Xenosb/thesis-atmel/README.md

# thesis-atmel

## Libraries
Some of the symbols and footprints are from KiCad Library
```https://github.com/KiCad/kicad-library```
