Xenosb/thesis-atmel/pcb/smartbed.kicad_pcb

## KiCad design pcb/smartbed.kicad_pcb (2017-06-22)

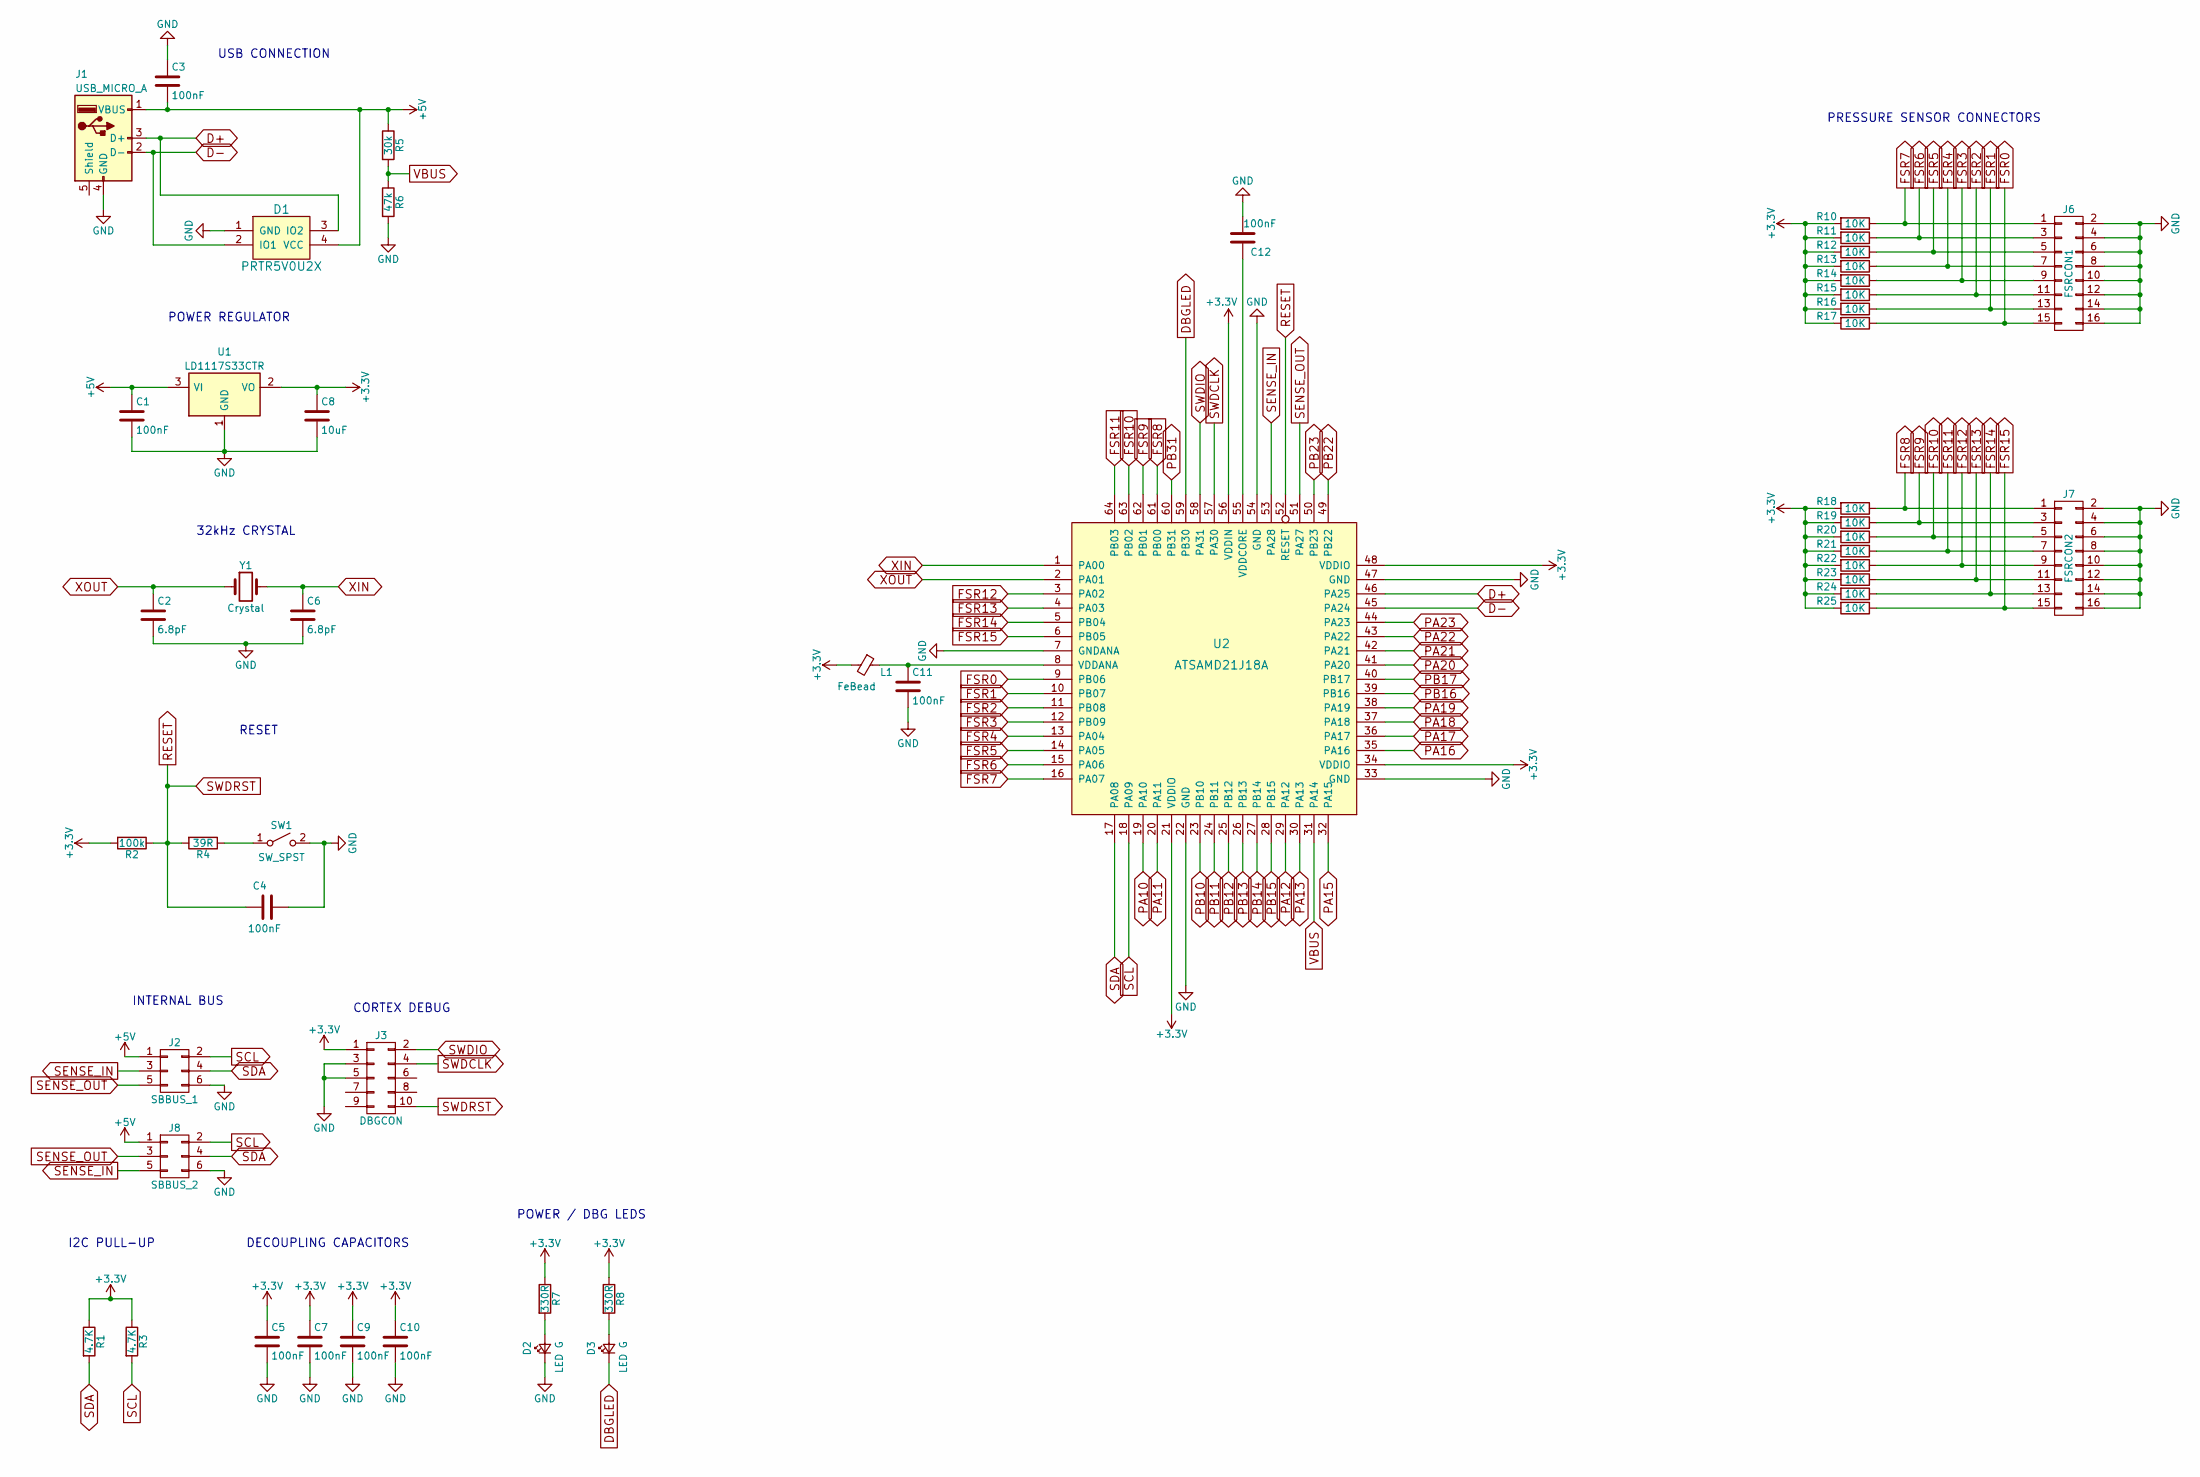
[picture p3: schematic smartbed.sch, Smartbed sense node]

Parts:
C1, C3, C4, C5, C7, C9, C10, C11, C12: 100nF; C_0603_HandSoldering
C2, C6: 6.8pF; C_0603_HandSoldering
C8: 10uF; C_0603_HandSoldering
D1: PRTR5V0U2X; SOT-143_Handsoldering
D2, D3: LED G; LED_0805
J1: USB_MICRO_A; USB_Micro-B
J2: SBBUS_1; IDC_Header_Straight_6pins
J3: DBGCON; IDC_Header_Straight_10pins
J6: FSRCON1; Pin_Header_Angled_2x08_Pitch2.54mm
J7: FSRCON2; Pin_Header_Angled_2x08_Pitch2.54mm
J8: SBBUS_2; IDC_Header_Straight_6pins
L1: FeBead; L_0603_HandSoldering
R1, R3: 4.7K; R_0805_HandSoldering
R2: 100k; R_0805_HandSoldering
R4: 39R; R_0805_HandSoldering
R5: 30k; R_0805_HandSoldering
R6: 47k; R_0805_HandSoldering
R7, R8: 330R; R_0805_HandSoldering
R10, R11, R12, R13, R14, R15, R16, R17, R18, R19, R20, R21, R22, R23, R24, R25: 10K; R_0805_HandSoldering
SW1: SW_SPST; SW_SPST_B3SL-1002P
U1: LD1117S33CTR; SOT-223
U2: ATSAMD21J18A; TQFP-64_10x10mm_Pitch0.5mm
Y1: Crystal; Crystal_Round_d3.0mm_Vertical

Connections:
+3V3: C5.1, C7.1, C8.1, C9.1, C10.1, J3.1, L1.2, R1.1, R2.2, R3.1, R7.1, R8.1, R10.2, R11.2, R12.2, R13.2, R14.2, R15.2, R16.2, R17.2, R18.2, R19.2, R20.2, R21.2, R22.2, R23.2, R24.2, R25.2, U1.2 (VO), U2.21 (VDDIO), U2.34 (VDDIO), U2.48 (VDDIO), U2.56 (VDDIN)
+5V: C1.1, C3.2, D1.4 (VCC), J1.1 (VBUS), J2.1, J8.1, R5.1, U1.3 (VI)
D+: D1.3 (IO2), J1.3 (D+), U2.46 (PA25)
D-: D1.2 (IO1), J1.2 (D-), U2.45 (PA24)
DBGLED: D3.1 (K), U2.59 (PB30)
FSR0: J6.15, R17.1, U2.9 (PB06)
FSR1: J6.13, R16.1, U2.10 (PB07)
FSR2: J6.11, R15.1, U2.11 (PB08)
FSR3: J6.9, R14.1, U2.12 (PB09)
FSR4: J6.7, R13.1, U2.13 (PA04)
FSR5: J6.5, R12.1, U2.14 (PA05)
FSR6: J6.3, R11.1, U2.15 (PA06)
FSR7: J6.1, R10.1, U2.16 (PA07)
FSR8: J7.1, R18.1, U2.61 (PB00)
FSR9: J7.3, R19.1, U2.62 (PB01)
FSR10: J7.5, R20.1, U2.63 (PB02)
FSR11: J7.7, R21.1, U2.64 (PB03)
FSR12: J7.9, R22.1, U2.3 (PA02)
FSR13: J7.11, R23.1, U2.4 (PA03)
FSR14: J7.13, R24.1, U2.5 (PB04)
FSR15: J7.15, R25.1, U2.6 (PB05)
GND: C1.2, C2.2, C3.1, C4.2, C5.2, C6.2, C7.2, C8.2, C9.2, C10.2, C11.2, C12.1, D1.1 (GND), D2.1 (K), J1.4 (GND), J2.6, J3.3, J3.5, J6.2, J6.4, J6.6, J6.8, J6.10, J6.12, J6.14, J6.16, J7.2, J7.4, J7.6, J7.8, J7.10, J7.12, J7.14, J7.16, J8.6, R6.2, SW1.2 (B), U1.1 (GND), U2.7 (GNDANA), U2.22 (GND), U2.33 (GND), U2.47 (GND), U2.54 (GND)
unnamed: C11.1, L1.1, U2.8 (VDDANA)
unnamed: C12.2, U2.55 (VDDCORE)
unnamed: D2.2 (A), R7.2
unnamed: D3.2 (A), R8.2
unnamed: R4.1, SW1.1 (A)
PA10: U2.19 (PA10)
PA11: U2.20 (PA11)
PA12: U2.29 (PA12)
PA13: U2.30 (PA13)
PA15: U2.32 (PA15)
PA16: U2.35 (PA16)
PA17: U2.36 (PA17)
PA18: U2.37 (PA18)
PA19: U2.38 (PA19)
PA20: U2.41 (PA20)
PA21: U2.42 (PA21)
PA22: U2.43 (PA22)
PA23: U2.44 (PA23)
PB10: U2.23 (PB10)
PB11: U2.24 (PB11)
PB12: U2.25 (PB12)
PB13: U2.26 (PB13)
PB14: U2.27 (PB14)
PB15: U2.28 (PB15)
PB16: U2.39 (PB16)
PB17: U2.40 (PB17)
PB22: U2.49 (PB22)
PB23: U2.50 (PB23)
PB31: U2.60 (PB31)
RESET: C4.1, J3.10, R2.1, R4.2, U2.52 (RESET)
SCL: J2.2, J8.2, R3.2, U2.18 (PA09)
SDA: J2.4, J8.4, R1.2, U2.17 (PA08)
SENSE_IN: J2.3, J8.5, U2.53 (PA28)
SENSE_OUT: J2.5, J8.3, U2.51 (PA27)
SWDCLK: J3.4, U2.57 (PA30)
SWDIO: J3.2, U2.58 (PA31)
VBUS: R5.2, R6.1, U2.31 (PA14)
XIN: C6.1, U2.1 (PA00), Y1.2
XOUT: C2.1, U2.2 (PA01), Y1.1

Notes on the sheet:
USB CONNECTION
INTERNAL BUS
POWER REGULATOR
32kHz CRYSTAL
RESET
I2C PULL-UP
CORTEX DEBUG
DECOUPLING CAPACITORS
POWER / DBG LEDS
PRESSURE SENSOR CONNECTORS

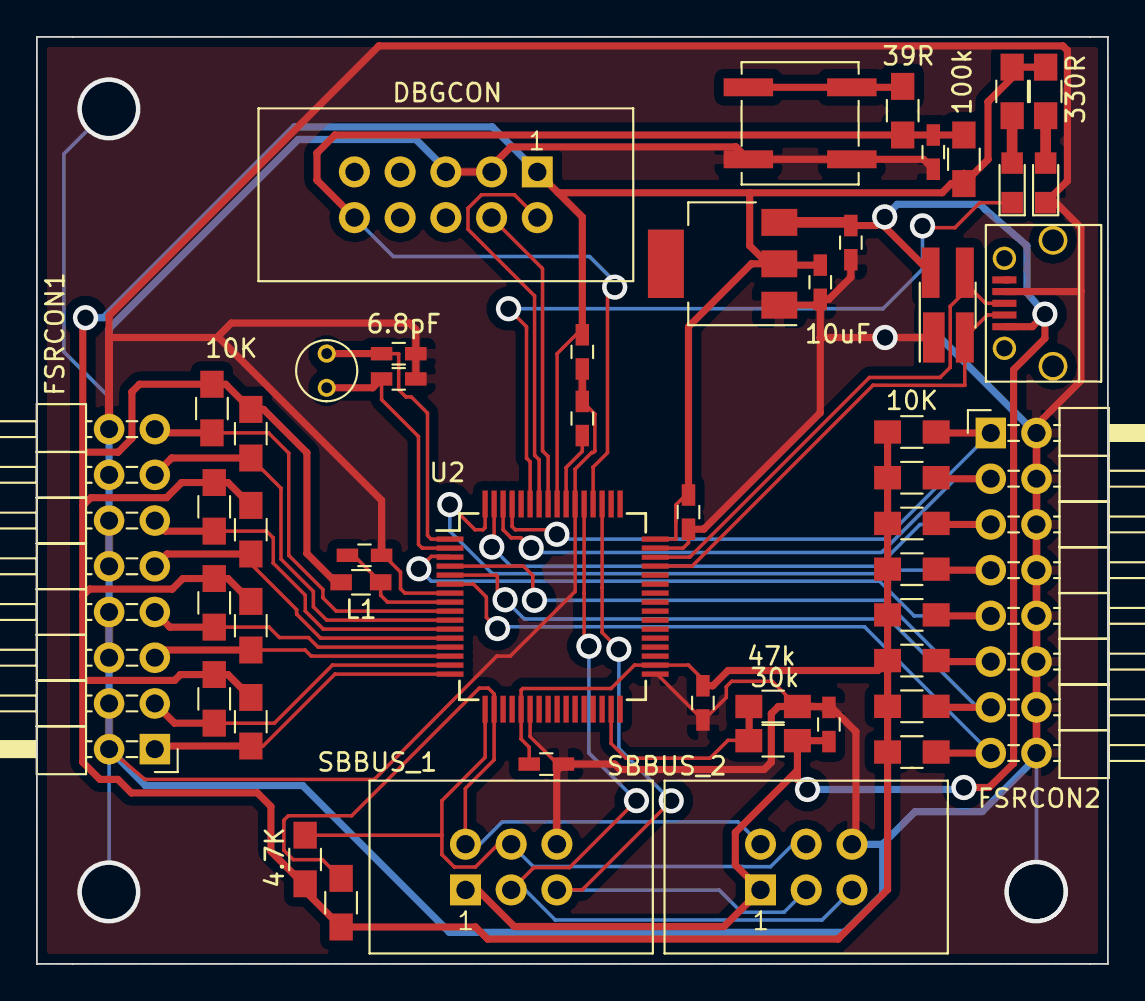
[picture p4: board smartbed.kicad_pcb from above]

Board: 2 copper layers, 59.5 x 51.5 mm, 50 parts (0 on the bottom side), 37 nets.
