Xenosb/thesis-atmel/firmware/src/main.cpp

#include "main.hpp"

I2CSlave slave(I2C_SDA_PIN, I2C_SCL_PIN);
DigitalOut led(LED_PIN);
DigitalIn sense_in(SENSE_IN_PIN);
DigitalOut sense_out(SENSE_OUT_PIN);
Smartbed smartbed(NODE_ADR, SENSOR_NUMBER);
Sensors sensors;
Ticker sensor_updater;

/**
==================
Main loop function
==================
*/
int main()
{

  led = 1;
  sense_out = 0;
  sense_in.mode(PullDown);

  slave.frequency(I2C_FREQ);
  slave.address(NODE_ADR);

  I2C_RESULT i2c_data;

  sensor_updater.attach(&update_all_sensors, 0.1);

  while (1)
  {
    i2c_data = i2c_slave_worker(slave);
    process_i2c_call(i2c_data);
  }
}

void update_all_sensors()
{
  sensors.update_all_sensors();
}

/**
====================
I2C process function
====================
*/
void process_i2c_call(I2C_RESULT i2c_data)
{
  switch (i2c_data.type)
  {
  case I2C_RESULT::None:
    return;
  case I2C_RESULT::WriteAddressed:
    process_write(i2c_data);
    break;
  case I2C_RESULT::ReadAddressed:
    // led = !led;
    process_read(i2c_data);
    break;
  case I2C_RESULT::WriteBroadcasted:
    process_broadcast(i2c_data);
    break;
  }
}

/**
===============================
Process write actions to node

registers
0xfa          - set i2c address
0xf0          - set sense_out
===============================
**/
void process_write(I2C_RESULT i2c_data)
{
  switch (i2c_data.reg)
  {
  case 0xfa:
    if (sense_in) {
      smartbed.set_address(i2c_data.reg_value);
      slave.address(i2c_data.reg_value);
    }
    break;
  case 0xf0:
    sense_out.write(i2c_data.reg_value);
    break;
  default:
    return;
  }
  slave.stop();
}

/**
========================================
Process read actions to node

registers
0x00 ... 0x0f - sensors individually (2B)
0xa0          - all sensors (sensor_n*2B)
0xfa          - i2c address (1B)
0xfb          - number of active sensors (1B)
0xfc          - board revision (1B)
0xfd          - firmware version (1B)
default       - echo 0xab == 17 (1B)
========================================
**/
void process_read(I2C_RESULT i2c_data)
{
  int i;
  uint16_t sensor_value;
  char sensor_vals[2];

  switch (i2c_data.reg)
  {
  case 0 ... 15:
    sensor_value = sensors.get_sensor(i2c_data.reg);
    sensor_vals[0] = char(sensor_value & 0x00ff);
    sensor_vals[1] = char(sensor_value >> 8);
    slave.write(sensor_vals, 2);
    break;
  case 0xa0:
    for (i=0; i<SENSOR_NUMBER; i++)
    {
      sensor_value = sensors.get_sensor(i);
      sensor_vals[0] = char(sensor_value & 0x00ff);
      sensor_vals[1] = char(sensor_value >> 8);
      slave.write(sensor_vals, 2);
    }
    break;
  case 0xfa:
    led != led;
    slave.write(smartbed.get_address());
    if (smartbed.get_address() == NODE_ADR)
      led = !led;
    break;
  case 0xfb:
    slave.write(smartbed.get_sensor_number());
    break;
  case 0xfc:
    slave.write(HW_VER);
    break;
  case 0xfd:
    slave.write(SW_VER);
    break;
  default:
    slave.write(0xab);
    return;
  }
  slave.stop();
}

/**
===========================================================
Process broadcast actions to node

accepted messages
[0xfa, 0x??]    - sets the node address if sense_in active
===========================================================
**/
void process_broadcast(I2C_RESULT i2c_data)
{
  if (i2c_data.data_length == 2 && i2c_data.long_data[0] == 0xfa && sense_in )
  {
    smartbed.set_address(i2c_data.long_data[1]);
  }
}

/**
==========================
I2C slave worker procedure
==========================
**/
I2C_RESULT i2c_slave_worker(I2CSlave slave)
{

  I2C_BYTE node_address = I2C_BYTE(slave.read());

  /* This slave was not addressed */
  if (node_address.data == -1)
  {
    return I2C_RESULT();
  }

  /* This slave was addressed with write */
  if (node_address.addr == smartbed.get_address() && !node_address.n_write)
  {

    int node_register = slave.read();
    I2C_BYTE read_write = I2C_BYTE(slave.read());

    if (read_write.n_write && read_write.addr == smartbed.get_address())
    {
      /* Master requests read from registry */
      return I2C_RESULT(node_register);
    }
    else
    {
      /* Master wrote to slave registry */
      return I2C_RESULT(node_register, read_write.data);
    }
  }

  if (node_address.addr == 0x00)
  {
    /* Broadcast to all slaves */
    int data[MAX_I2C_DATA_SIZE];
    int length = 0;

    while (true)
    {
      int r_byte = slave.read();
      if (r_byte == -1)
        break;
      data[length] = r_byte;
      length++;
    }

    return I2C_RESULT(length, data);
  }

  return I2C_RESULT();
}
