Xenosb/thesis-atmel/(commit log)

2017-06-08 Added SAMD21 to library
    [smartbed.kicad_pcb, smartbed.sch]
2017-06-09 Added power supply, USB, internal bus
    [smartbed.sch]
2017-06-09 Added I2C pull ups, reset button, xtal
    [smartbed.sch]
2017-06-11 Added debug connector and capacitors
    [smartbed.sch]
2017-06-11 Added FSR connectors
    [smartbed.sch]
2017-06-11 Assigned footprints, started PCB
    [smartbed.kicad_pcb, smartbed.sch]
2017-06-12 Biggest part of board done
    [_saved_smartbed.sch, smartbed.kicad_pcb]
2017-06-12 Connected most of the traces
    [smartbed.kicad_pcb, smartbed.sch]
2017-06-13 Routed the board
    [_saved_smartbed.sch, smartbed.kicad_pcb, smartbed.sch]
2017-06-13 Revision 1
    [smartbed.kicad_pcb]
2017-06-13 Revision 2
    [smartbed.kicad_pcb, smartbed.sch]
2017-06-13 Edit board references
    [smartbed.kicad_pcb]
2017-06-13 Add ground planes
    [smartbed.kicad_pcb]
2017-06-14 Updated design to conform HTWG rules
    [smartbed.kicad_pcb]
2017-06-14 Minor PCB changes
    [smartbed.kicad_pcb]
2017-06-22 Minor changes to PCB, added HTML BOM
    [smartbed.kicad_pcb, smartbed.sch]
2017-07-08 Added upload script and working i2c implementation
2017-07-08 Fixed i2c broadcast address
    [main.cpp, main.hpp]
2017-07-09 Added I2C result class
2017-07-09 Organized i2c read, write and broadcast functions
2017-07-09 Added read and broadcaste i2c functions, added sense pins
2017-07-09 i2c address change and sense out write tested working
2017-07-10 Reading single sensor works
2017-07-11 All sensor data request added
2017-08-28 Fixed wierd issue with node sending only 1 byte over I2C when sensor was read
    [main.cpp]
